DalhousieSpaceSystemsLab/CubeSat-EPS-Hardware/docs/EPS Prototype 1 (cell level protection)/BOM.xlsx

Index | Quantity | Part Number | Manufacturer Part Number | Description | Customer Reference | Available | Backorder | Unit Price | Extended Price CAD
1 | 1 | 63.4KXBK-ND | MFR-25FBF52-63K4 | RES 63.4K OHM 1/4W 1% AXIAL |  | 1 | 0 | 0.14 | 0.14
2 | 2 | 1189-1330-ND | 400LLE2R2MEFC8X9 | CAP ALUM 2.2UF 20% 400V RADIAL |  | 2 | 0 | 0.62 | 1.24
3 | 1 | 513-1673-ND | CTX100-1-52-R | FIXED IND 100UH 2.5A 106 MOHM TH |  | 0 | 1 | 5.14 | 5.14
4 | 1 | 732-7149-ND | 744750230100 | FIXED IND 10UH 4.6A 23 MOHM TH |  | 1 | 0 | 2.54 | 2.54
5 | 1 | CMF1.91MHFCT-ND | CMF551M9100FHEB | RES 1.91M OHM 1/2W 1% AXIAL |  | 1 | 0 | 2.13 | 2.13
6 | 1 | PPC200KW-1CT-ND | PR01000102003JR500 | RES 200K OHM 1W 5% AXIAL |  | 1 | 0 | 0.3 | 0.30
7 | 3 | 399-15738-ND | ESL106M100AE3AA | CAP ALUM 10UF 20% 100V THRU HOLE |  | 3 | 0 | 0.39 | 1.17
8 | 1 | BC4228CT-ND | MRS25000C6193FCT00 | RES 619K OHM 0.6W 1% AXIAL |  | 1 | 0 | 0.35 | 0.35
9 | 3 | P5308-ND | ECA-2AM4R7 | CAP ALUM 4.7UF 20% 100V RADIAL |  | 3 | 0 | 0.33 | 0.99
10 | 2 | P15788CT-ND | EEA-GA1C150B | CAP ALUM 15UF 20% 16V RADIAL |  | 2 | 0 | 0.39 | 0.78
11 | 1 | 490-4927-1-ND | GCM1555C1H221JA16D | CAP CER 220PF 50V C0G/NP0 0402 |  | 1 | 0 | 0.14 | 0.14
12 | 1 | CRM2512-FX-R250ELFCT-ND | CRM2512-FX-R250ELF | RES 0.25 OHM 1% 2W 2512 |  | 1 | 0 | 1.78 | 1.78
13 | 5 | S7000-ND | PPTC021LFBN-RC | CONN HDR 2POS 0.1 TIN PCB |  | 5 | 0 | 0.43 | 2.15
14 | 2 | 641-1303-1-ND | CPDU5V0U-HF | TVS DIODE 5V 12.5V 0603 |  | 2 | 0 | 0.54 | 1.08
15 | 2 | 277-1667-ND | 1935161 | TERM BLK 2POS SIDE ENTRY 5MM PCB |  | 0 | 2 | 0.58 | 1.16
16 | 1 | 1276-1235-1-ND | CL05A105MQ5NNNC | CAP CER 1UF 6.3V X5R 0402 |  | 0 | 1 | 0.14 | 0.14
17 | 10 | 311-1KMCT-ND | RC0201FR-071KL | RES SMD 1K OHM 1% 1/20W 0201 |  | 10 | 0 | 0.058 | 0.58
18 | 1 | UPS115UE3/TR7CT-ND | UPS115UE3/TR7 | DIODE SCHOTTKY 15V 1A POWERMITE |  | 1 | 0 | 1.58 | 1.58
19 | 1 | 513-1548-ND | CTX50-2-52-R | FIXED IND 50UH 4.9A 32.6 MOHM TH |  | 0 | 1 | 7.07 | 7.07
20 | 1 | 478-1129-1-ND | 0402ZD104KAT2A | CAP CER 0.1UF 10V X5R 0402 |  | 1 | 0 | 0.14 | 0.14
21 | 12 | ED11195-ND | 801-47-001-10-001000 | CONN RCPT 1POS GOLD PCB |  | 12 | 0 | 0.552 | 6.62
22 | 2 | RHM330AICT-ND | KTR18EZPF3300 | RES SMD 330 OHM 1% 1/4W 1206 |  | 2 | 0 | 0.29 | 0.58
23 | 2 | 490-13969-1-ND | GRM31CR60J157ME11L | CAP CER 150UF 6.3V X5R 1206 |  | 2 | 0 | 1.55 | 3.10
24 | 3 | SI6423DQ-T1-E3CT-ND | SI6423DQ-T1-E3 | MOSFET P-CH 12V 8.2A 8TSSOP |  | 3 | 0 | 2.51 | 7.53
25 | 1 | 2663S-36-ND | 26633601RP2 | CONN HEADER VERT 36POS 2MM |  | 1 | 0 | 4.48 | 4.48
26 | 2 | WSLC-.06CT-ND | WSL1206R0600FEA | RES 0.06 OHM 1% 1/4W 1206 |  | 2 | 0 | 1.22 | 2.44
27 | 3 | A106650-ND | 215297-3 | CONN RCPT 3POS 0.1 GOLD PCB |  | 3 | 0 | 1.18 | 3.54
28 | 10 | SAM10729-ND | SQT-102-01-F-S | CONN RCPT 2POS 0.079 GOLD PCB |  | 0 | 10 | 0.935 | 9.35
29 | 2 | 1276-1287-1-ND | CL31A226KPHNNNE | CAP CER 22UF 10V X5R 1206 |  | 2 | 0 | 0.54 | 1.08
30 | 2 | 311-7.5KERCT-ND | RC1206JR-077K5L | RES SMD 7.5K OHM 5% 1/4W 1206 |  | 2 | 0 | 0.14 | 0.28
31 | 4 | 563-1976-5-ND | CFS-0102MA | SWITCH DIP SPST 100MA 6V |  | 4 | 0 | 1.67 | 6.68
32 | 2 | LTC6995CS6-1#TRMPBFCT-ND | LTC6995CS6-1#TRMPBF | IC OSC SILICON PROG TSOT23-6 |  | 2 | 0 | 5.41 | 10.82
33 | 2 | 296-37669-1-ND | TPS2557DRBR | IC PWR SWITCH N-CHAN 1:1 8SON |  | 0 | 2 | 2.03 | 4.06
34 | 2 | 408-2038-1-ND | RG3216P-5004-B-T1 | RES 5M OHM 0.1% 1/4W 1206 |  | 2 | 0 | 0.95 | 1.90
35 | 2 | 732-7683-1-ND | 885012208011 | CAP CER 0.47UF 10V X7R 1206 |  | 2 | 0 | 0.26 | 0.52
36 | 2 | LTC4002ES8-4.2#TRPBFCT-ND | LTC4002ES8-4.2#TRPBF | IC BATT CHG LI-ION 1CELL 8SOIC |  | 2 | 0 | 7.19 | 14.38
37 | 2 | A106075CT-ND | CRG1206F2K2 | RES SMD 2.2K OHM 1% 1/4W 1206 |  | 2 | 0 | 0.14 | 0.28
38 | 2 | 296-25857-1-ND | CSD17307Q5A | MOSFET N-CH 30V 14A/73A 8VSON |  | 2 | 0 | 1.11 | 2.22
39 | 3 | 160-1457-1-ND | LTST-C230KRKT | LED RED CLEAR CHIP SMD |  | 3 | 0 | 0.42 | 1.26
40 | 3 | 732-8086-1-ND | 885012208009 | CAP CER 0.1UF 10V X7R 1206 |  | 3 | 0 | 0.15 | 0.45
41 | 2 | TNP2.00KACCT-ND | TNPW12062K00BEEA | RES 2K OHM 0.1% 2/5W 1206 |  | 0 | 2 | 0.91 | 1.82
42 | 2 | B330-FDICT-ND | B330-13-F | DIODE SCHOTTKY 30V 3A SMC |  | 2 | 0 | 0.72 | 1.44
43 | 2 | 36-1042-ND | 1042 | BATTERY HOLDER 18650 SMD TAB |  | 2 | 0 | 5.34 | 10.68
44 | 2 | 1276-1148-1-ND | CL31A106KPHNNNE | CAP CER 10UF 10V X5R 1206 |  | 2 | 0 | 0.3 | 0.60
45 | 2 | IPC0083-ND | IPC0083 | DFN-6 TO DIP-10 SMT ADAPTER |  | 2 | 0 | 6.51 | 13.02
46 | 1 | 495-5572-1-ND | B78108S1682K000 | FIXED IND 6.8UH 670MA 510 MOHM |  | 1 | 0 | 0.52 | 0.52
47 | 1 | HM3316-ND | 1532A | FIXED IND 10UH 1.5A 110 MOHM TH |  | 1 | 0 | 2.83 | 2.83
48 | 1 | 535-13015-ND | AIAP-02-5R6K | FIXED IND 5.6UH 5.6A 24 MOHM TH |  | 1 | 0 | 0.73 | 0.73
