DalhousieSpaceSystemsLab/CubeSat-EPS-Hardware/docs/MPPT Prototype/SPV1040_BOM.xlsx

Index | Quantity | Part Number | Manufacturer Part Number | Description | Customer Reference | Available | Backorder | Unit Price | Extended Price USD
1 | 2 | 497-11417-ND | SPV1040T | IC BATTERY CHARGER SOLAR 8TSSOP |  | 2 | 0 | 3.16 | 6.32
2 | 3 | 490-10525-1-ND | GRM31CD80J107ME39L | CAP CER 100UF 6.3V X6T 1206 |  | 3 | 0 | 0.69 | 2.07
3 | 3 | 399-8131-1-ND | C1206C102J5RACTU | CAP CER 1000PF 50V X7R 1206 |  | 3 | 0 | 0.19 | 0.57
4 | 12 | 2057-SMC-1-01-1-GT-ND | SMC-1-01-1-GT | MACHINE PIN SOCKET 1P 1.00MM PIT |  | 12 | 0 | 0.104 | 1.25
5 | 2 | 311-1.0KERCT-ND | RC1206JR-071KL | RES SMD 1K OHM 5% 1/4W 1206 |  | 2 | 0 | 0.1 | 0.20
6 | 2 | A140693CT-ND | RQ73C2B768KBTD | RES 768 KOHMS 0.1% 0.4W 1206 |  | 2 | 0 | 0.92 | 1.84
7 | 2 | P330KBCCT-ND | ERA-8AEB334V | RES SMD 330K OHM 0.1% 1/4W 1206 |  | 2 | 0 | 0.66 | 1.32
8 | 2 | 495-5656-1-ND | B82442T1103K050 | FIXED IND 10UH 1.42A 132 MOHM |  | 2 | 0 | 1.48 | 2.96
