DalhousieSpaceSystemsLab/CubeSat-EPS-Hardware/docs/POW Subsystem Test Plan.xlsx

 | Power Subsystem Test Plan |  |  |  |  | Document Code: LORIS-POW-TEC-02
Testing Plan:
Requirement | Method of Verification (A, I, D, T) | Facility | Device Used | Description of Test | Success Criteria | Requirement Content For Reference
[SYS-POW-010] |  |  |  |  |  | The spacecraft power generation system shall be made of solar arrays and batteries and shall cope with the power needs of the various spacecraft subsystems as required.
[SYS-POW-020] |  |  |  |  |  | The Power subsystem shall generate, store, manage, and distribute power to support payload and housekeeping operations throughout all mission phases.
[SYS-POW-030] | A, D |  | Multimeter | Battery pack will be monitored with multimeter while providing power to subsystems. | Batteries are demonstrated to store at least 40 Whr | The spacecraft battery shall store a minimum 40 Whr of electrical power to operate the payload and subsystems when solar power is not available.
[SYS-POW-031] | A, T |  | MATLAB | Simulations are run to determine state of worst case eclipse. Batteries are tested to this limit. | Batteries are shown to sustain enough power to survive worst case eclipse scenarios | The spacecraft battery shall be sized for worst case eclipses.
[SYS-POW-032] | A, D |  | Multimeter | Batteries will be charged until overcharge circuitry prevents charging. | Overcharge circuitry demonstrates that the energy stored shall not exceed 80Whr | Total chemical energy stored shall not exceed 80 Whr as specified by Nanoracks in [AD4].
[SYS-POW-040] | A,T |  | Multimeter, External Power supply | Protection circuitry will be tested by forcing the battery pack into over charge/discharge conditions. | Protection circuitrysucesfully protects battery back against over-charge, over-discharge, short-circuit, charge over-current, and discharge over-current events. | The battery pack must contain integrated protection against over-charge, over-discharge, short-circuit, charge over-current, and discharge over-current events.
[SYS-POW-050] | I, T |  | Multimeter | A external charging port will be designed then integrated with the battery pack then tested using a multimeter | Batteries scuesfully gain charge via external charging port
[SYS-POW-051] | A, D |  | Multimeter | All subsystems are disconnected from ground when external charging port is in use | External charging port only provides power to battery pack | The external charging port must not provide power to any of the loads.
[SYS-POW-060] | D |  | N/A | The spacecraft development will use test batteries |  | Test batteries shall be used during ground test activities.
[SYS-POW-061] | D |  | N/A | Flight cells will be used to power final stages of spacecraft leveling testing | Flight batteries sucesfully supply power in final spacecraft level testing. | Flight batteries shall be included in final spacecraft level testing.
[SYS-POW-080] | A |  | MATLAB | Simulations are run to determine depth of discharge over 9 months. | Depth of discharge over 9 months is less than 50% | While in a cold launch configuration, the batteries shall be capable of holding a charge for 9 months with a resulting DoD of no more than 50%.
[SYS-POW-090] | A |  | CAD Software, Visual inspection | Confirmed by reviewing circuit design and board design that regulators are placed for centralized distributions | Regulators are centralized to minimize path of power | The PDU shall have centralized power distribution.
[SYS-POW-100] | D |  | Master/Slave connection | PDU will turn active loads on and off. PDU will monitor andgenerate reports of voltage and current consumptions. | PDU monitors and controls power distribution and sucesfully generates reports upon request. | The PDU shall perform power conditioning, switching, internal monitoring and reporting of voltage and current.
[SYS-POW-110] | A, D |  | Multimeter, External Power supply | Load switches will be stressed test with over voltage, over current and under voltage scenarios | PDU is sucesfully protects itself and subsystems from over voltage/current and under voltage protection | The PDU shall include necessary over voltage, over current, and under voltage protection.
[SYS-POW-120] | D |  | Multimeter | PDU board voltage lines will be measured while providing to load(s) | 3.3±0.2V and 5±0.2V measurements are taken | The PDU shall provide regulated 3.3±0.2V and 5±0.2V supply.
[SYS-POW-130] | D |  | Master/Slave connection | OBC request telemetry from PDU | OBC sucesfully receives data request from PDU | The PDU shall provide all necessary telemetry data to the OBC.
[SYS-POW-140] | D |  | Multimeter | Multimeter will be used to measure power supplied to during a power intensive operations. | Power observed is 10 W or greater | The PDU shall supply at least 10 W during transient power-intensive operations such as during downlink.
[SYS-POW-150] | D |  | Multimeter | Multimeter will be used to measure power supplied to during a nominal operation | Power observed is 4 W or greater | The PDU shall supply at least 4 W during nominal operations.
[SYS-POW-160] | D |  | Multimeter | Multimeter will be used to measure instantaneous current of a load that draws more then 150% of its max expected load current | Load switches sucesfully latch at 150% of each loads expected max current. Load switches sucesfully reset the power. | Each power line shall provide an appropriately sized resettable latching current limit equal to 150% of max expected load for each circuit.
[SYS-POW-170] | D |  | Multimeter | Load switches will be toggled on and off | Load switches sucesfully turn a load on/off | Each power channel shall be capable of being turned on and off in response to commands from the OBC.
[SYS-POW-180] | I |  | Multimeter | Multimeter will be used to check for path to ground. | Every point on spacecraft is an open circuit to ground. | The power subsystem shall include a minimum of three inhibit switches that keep the satellite in a powered-down state.
[SYS-POW-181] | D |  | Multimeter | Run a demonstration of the timer circuitry | Power system is activated only after 30 minute timer | The PDU shall provide power to the loads at least 30 minutes after all three inhibit switches are closed.
[SYS-POW-182] | D |  | Multimeter | Run a demonstration of the timer circuitry, toggling an inhibit switch to test the timer reset | Timer is reset after the toggle is switched | If any of the three inhibit switches are toggled during the 30-minute period, the timer must reset.
[SYS-POW-190] | I, D | NR Int. Facility |  |  |  | The power subsystem shall be in a power off state while integrated in the CubeSat deployer from the time of delivery to the Launch Vehicle (LV) through on-orbit deployment.
[SYS-POW-200] | I, D |  | Multimeter | Multimeter will be used to check for path to ground. | RBF pin sucessfuly removes path to ground. | LORIS shall have a remove before flight (RBF) feature or an apply before flight (ABF) feature that keeps the satellite in an unpowered state throughout the ground handling and integration process into the deployer.
[SYS-POW-201] | I, D | NR Int. Facility |  |  |  | The RBF pin shall cut all power to the satellite once it is inserted into the CubeSat Deployer.
[SYS-POW-202] | D | NR Int. Facility |  |  |  | The RBF pin shall be removed after integration into the CubeSat Deployer.
[SYS-POW-220] | A,D, T |  | Multimeter, Oscilloscope | Osciloscope will be used to measure the SNR at various points of the spacecraft to ground. | Electrical noise from ground do not cause systems to behave undefined. | The power subsystem shall be designed to be free of any grounding issues that affect the performance of the components.
[SYS-POW-230] | A, T |  | N/A | Lifetime of solar cells must be greater then 1.5 years | Solar cells chosen must have lifetime of 1.5 years | The solar panels shall have an operational lifetime of at least 1.5 years
[SYS-POW-231] | A, T |  | MATLAB | MATLAB simulations will be used to perfom accelerated fatigue test. | Simulations result in EOL better than 25% effeciency | The solar panels shall be at least 25% efficient at end of life.
[SYS-POW-240] | D |  | Multimeter | Over current protection will be monitored for over current scenarios. | Power distribution to each subsystem does not cause shorts. | The power subsystem shall provide the grounding and bonding interface between connected systems with no shorts between ground lines and power supply lines.
[SYS-POW-250] | A, D |  | Scale | A scale is used to measure the mass of the power subsystem | The mass is less than 500 g | The power subsystem shall have a mass that does not exceed 500 g.
[SYS-POW-260] | D | NR Int. Facility
