DalhousieSpaceSystemsLab/CubeSat-EPS-Hardware/docs/Solar Wall Prototype/Wall Dimensions.PDF

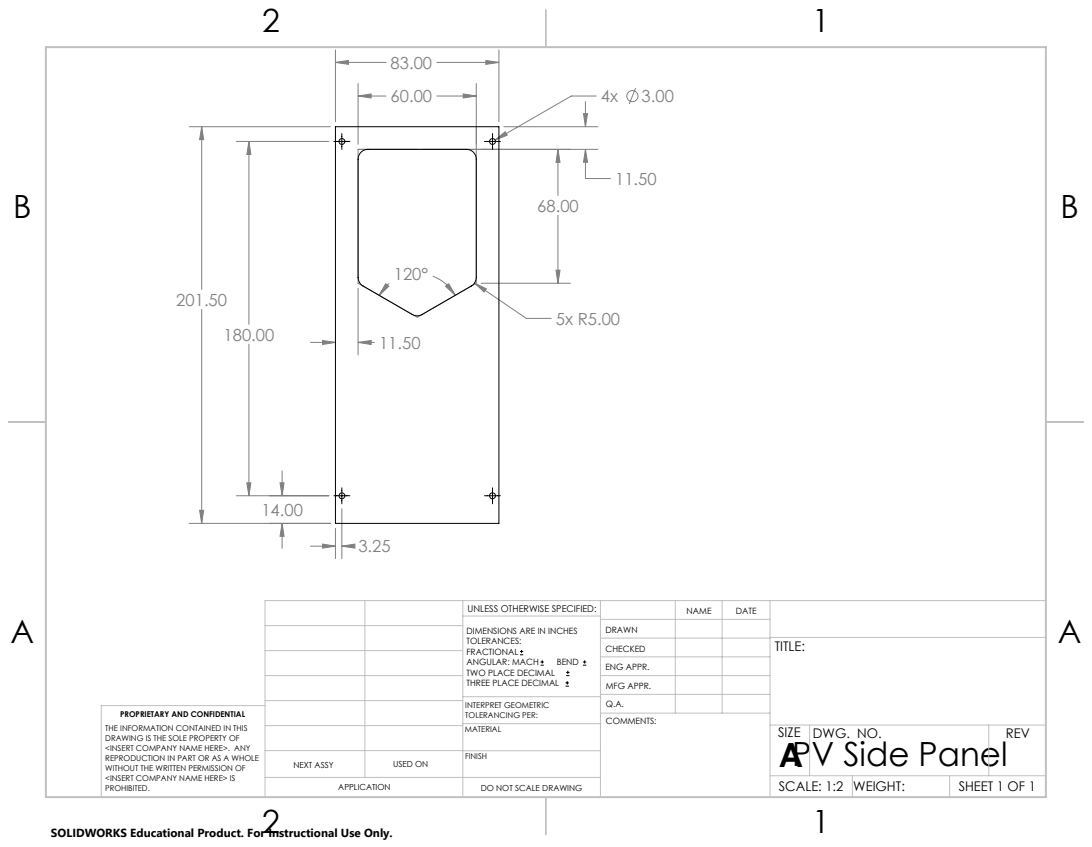
[picture p38: page 1]

UNLESS OTHERWISE SPECIFIED: | | NAME | DATE
DIMENSIONS ARE IN INCHES TOLERANCES: FRACTIONAL ANGULAR: MACH BEND TWO PLACE DECIMAL THREE PLACE DECIMAL | DRAWN

CHECKED | | | TITLE:

ENG APPR.
MFG APPR.

INTERPRET GEOMETRIC TOLERANCING PER: | Q.A.
MATERIAL | | SIZE A PV Side Panel | DWG. NO. | REV

PROPRIETARY AND CONFIDENTIAL
THE INFORMATION CONTAINED IN THIS
DRAWING IS THE SOLE PROPERTY OF
<INSERT COMPANY NAME HERE>. ANY
REPRODUCTION IN PART OR AS A WHOLE
WITHOUT THE WRITTEN PERMISSION OF
<INSERT COMPANY NAME HERE> IS
PROHIBITED.

NEXT ASSY | USED ON | FINISH

APPLICATION | DO NOT SCALE DRAWING | | SCALE: 1:2 | WEIGHT: | SHEET 1 OF 1

SOLIDWORKS Educational Product. For Instructional Use Only.
