DalhousieSpaceSystemsLab/CubeSat-EPS-Hardware/eagle project/PDUv1/PDUv1.pdf

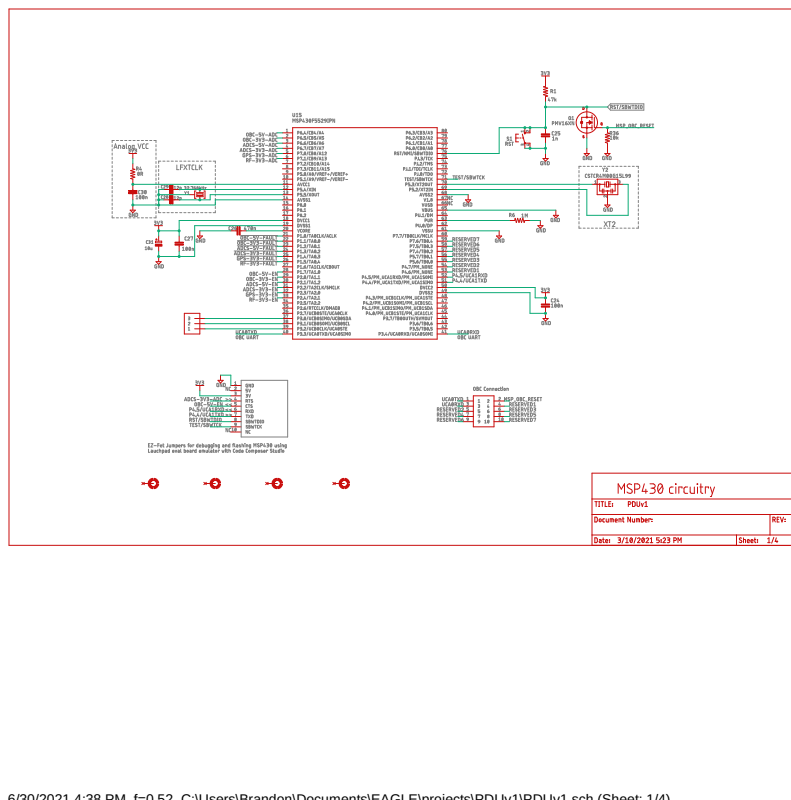
[picture p40: page 1]

6/30/2021 4:38 PM f=0.52 C:\Users\Brandon\Documents\EAGLE\projects\PDUv1\PDUv1.sch (Sheet: 1/4)

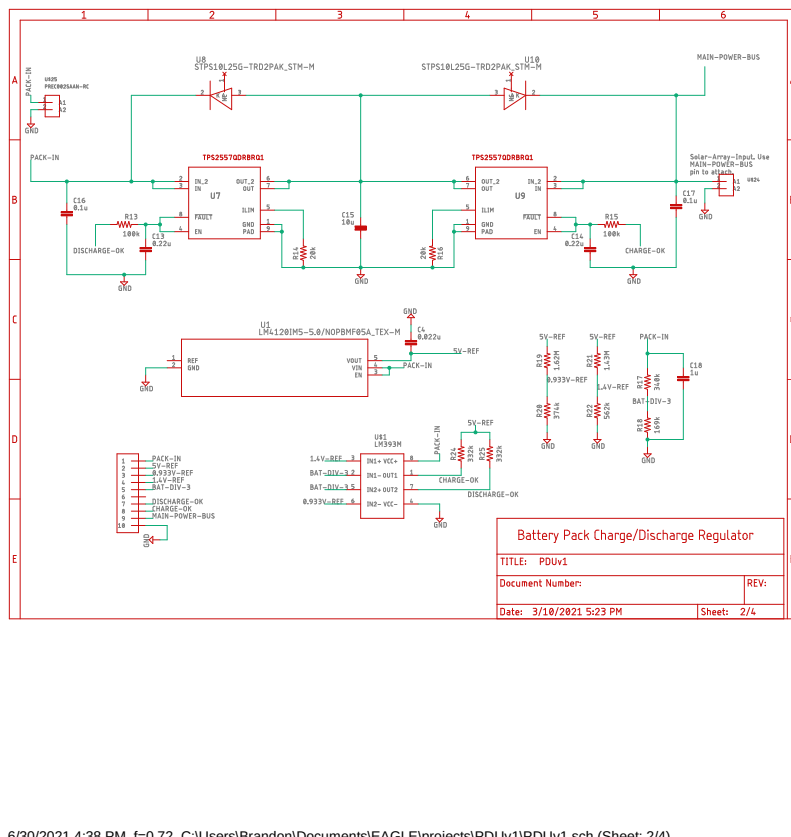
[picture p41: page 2]

6/30/2021 4:38 PM f=0.72 C:\Users\Brandon\Documents\EAGLE\projects\PDUv1\PDUv1.sch (Sheet: 2/4)

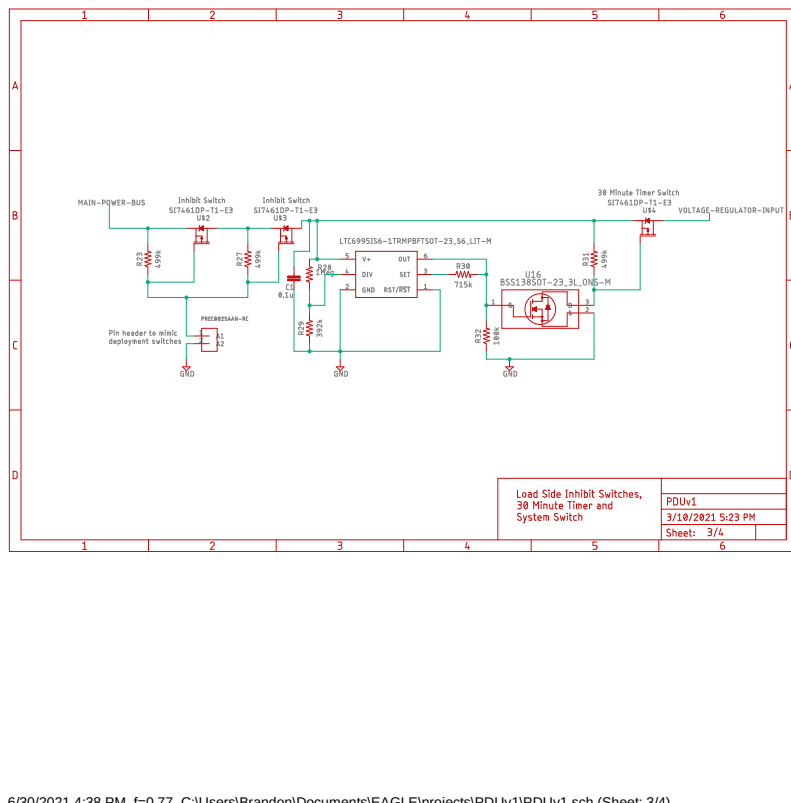
[picture p42: page 3]

6/30/2021 4:38 PM f=0.77 C:\Users\Brandon\Documents\EAGLE\projects\PDUv1\PDUv1.sch (Sheet: 3/4)

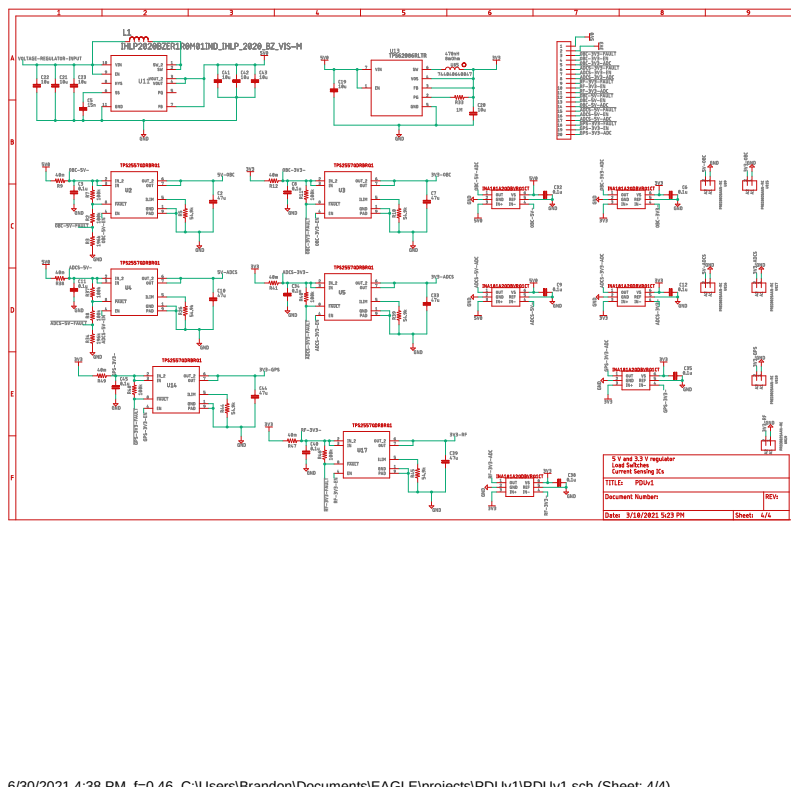
[picture p43: page 4]

6/30/2021 4:38 PM f=0.46 C:\Users\Brandon\Documents\EAGLE\projects\PDUv1\PDUv1.sch (Sheet: 4/4)
