DalhousieSpaceSystemsLab/CubeSat-EPS-Hardware/eagle project/PDUv2/PDUv2.brd

## EAGLE design eagle project/PDUv2/PDUv2.brd (2021-08-02)

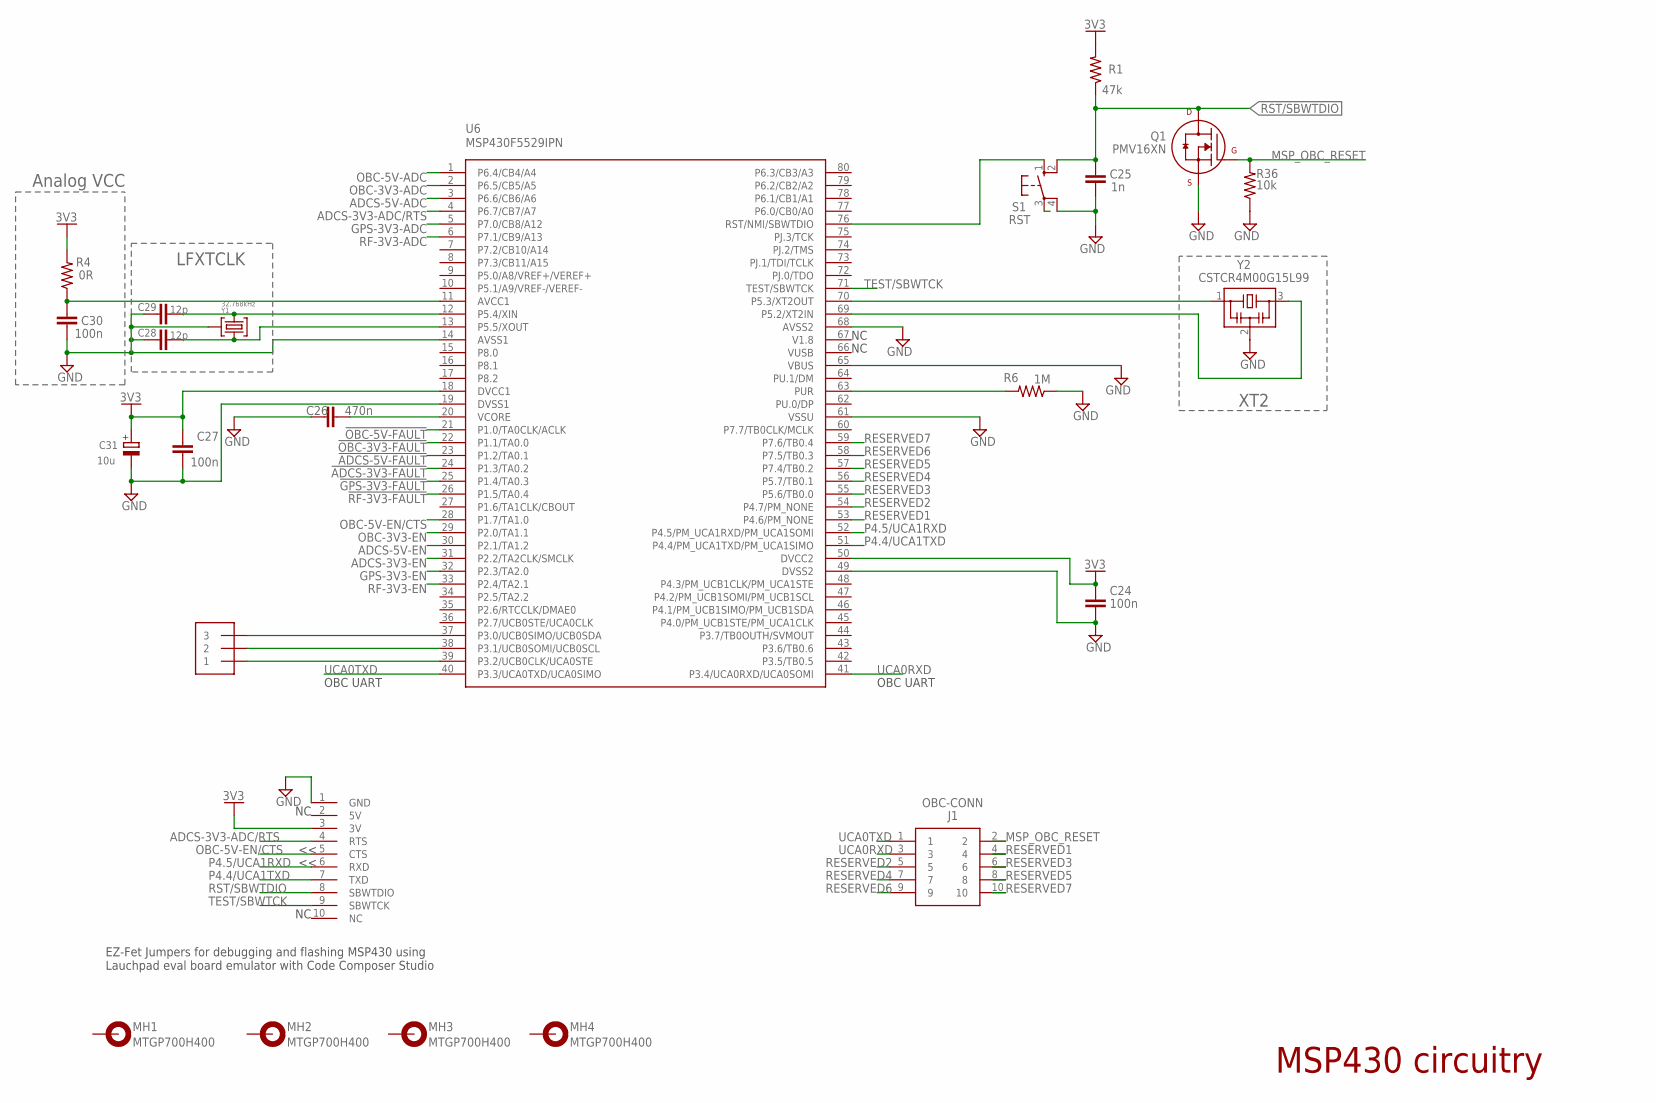
[picture p44: schematic PDUv2.sch, sheet 1]

Parts:
C24, C27, C30: 100n; C0402
C25: 1n; C0402
C26: 470n; C0402
C28, C29: 12p; C0402
C31: 10u; A/3216-18R
J1: OBC-CONN
J5: HDR_10_EZFET_DEBUGGER; HDRV10W66P254_10X1_2540X254H858
MH1, MH2, MH3, MH4: MTGP700H400
Q1: PMV16XN; SOT23-3P95_230X110L20X43N_PMV16XN
R1: 47k; R0402
R4: 0R; R0402
R6: 1M; R0603
R36: 10k; R0603
S1: RST; B3F-10XX
U6: MSP430F5529IPN; QFP80P50_1400X1400X160L60X22N
U$23: GRPB031VWTC-RC
Y1: 32.768kHz; MS3V-T1R
Y2: CSTCR4M00G15L99; MURATA-FILTER_CSTCR

Connections:
3V3: C27.2, C31.+, J5.3 (3V), R1.2, R4.2, U6.18 (DVCC1); also elsewhere on the board
!ADCS-3V3-FAULT: U6.24 (P1.3/TA0.2); also elsewhere on the board
!ADCS-5V-FAULT: U6.23 (P1.2/TA0.1); also elsewhere on the board
!GPS-3V3-FAULT: U6.25 (P1.4/TA0.3); also elsewhere on the board
!OBC-3V3-FAULT: U6.22 (P1.1/TA0.0); also elsewhere on the board
!OBC-5V-FAULT: U6.21 (P1.0/TA0CLK/ACLK); also elsewhere on the board
!RF-3V3-FAULT: U6.26 (P1.5/TA0.4); also elsewhere on the board
ADCS-3V3-ADC/RTS: J5.4 (RTS), U6.4 (P6.7/CB7/A7); also elsewhere on the board
ADCS-3V3-EN: U6.31 (P2.2/TA2CLK/SMCLK); also elsewhere on the board
ADCS-5V-ADC: U6.3 (P6.6/CB6/A6); also elsewhere on the board
ADCS-5V-EN: U6.30 (P2.1/TA1.2); also elsewhere on the board
AVCC1: C30.1, R4.1, U6.11 (AVCC1)
GND: C24.2, C25.2, C26.1, C27.1, C28.1, C29.1, C30.2, C31.-, J5.1 (GND), Q1.2 (S), R6.1, R36.1, S1.4 (P1), U6.14 (AVSS1), U6.19 (DVSS1), U6.49 (DVSS2), U6.61 (VSSU), U6.65 (VBUS), U6.68 (AVSS2), Y1.P3 (GND), Y2.2; also elsewhere on the board
GPS-3V3-ADC: U6.5 (P7.0/CB8/A12); also elsewhere on the board
GPS-3V3-EN: U6.32 (P2.3/TA2.0); also elsewhere on the board
MSP_OBC_RESET: J1.2, Q1.1 (G), R36.2
unnamed: C24.1, U6.50 (DVCC2)
unnamed: S1.1 (S), U6.76 (RST/NMI/SBWTDIO)
OBC-3V3-ADC: U6.2 (P6.5/CB5/A5); also elsewhere on the board
OBC-3V3-EN: U6.29 (P2.0/TA1.1); also elsewhere on the board
OBC-5V-ADC: U6.1 (P6.4/CB4/A4); also elsewhere on the board
OBC-5V-EN/CTS: J5.5 (CTS), U6.28 (P1.7/TA1.0); also elsewhere on the board
P4.4/UCA1TXD: J5.7 (TXD), U6.51 (P4.4/PM_UCA1TXD/PM_UCA1SIMO)
P4.5/UCA1RXD: J5.6 (RXD), U6.52 (P4.5/PM_UCA1RXD/PM_UCA1SOMI)
P5.2/XT2IN1: U6.69 (P5.2/XT2IN), Y2.3
P5.3/XT2OUT1: U6.70 (P5.3/XT2OUT), Y2.1
P5.4/XIN1: C29.2, U6.12 (P5.4/XIN), Y1.P1 (1)
P5.5/XOUT1: C28.2, U6.13 (P5.5/XOUT), Y1.P2 (2)
RESERVED1: J1.4, U6.53 (P4.6/PM_NONE)
RESERVED2: J1.5, U6.54 (P4.7/PM_NONE)
RESERVED3: J1.6, U6.55 (P5.6/TB0.0)
RESERVED4: J1.7, U6.56 (P5.7/TB0.1)
RESERVED5: J1.8, U6.57 (P7.4/TB0.2)
RESERVED6: J1.9, U6.58 (P7.5/TB0.3)
RESERVED7: J1.10, U6.59 (P7.6/TB0.4)
RF-3V3-ADC: U6.6 (P7.1/CB9/A13); also elsewhere on the board
RF-3V3-EN: U6.33 (P2.4/TA2.1); also elsewhere on the board
RST/SBWTDIO: C25.1, J5.8 (SBWTDIO), Q1.3 (D), R1.1, S1.2 (S1)
TARGET_PUR: R6.2, U6.63 (PUR)
TEST/SBWTCK: J5.9 (SBWTCK), U6.71 (TEST/SBWTCK)
UCA0RXD: J1.3, U6.41 (P3.4/UCA0RXD/UCA0SOMI)
UCA0TXD: J1.1, U6.40 (P3.3/UCA0TXD/UCA0SIMO)
UCB0CLK: U6.39 (P3.2/UCB0CLK/UCA0STE), U$23.1
UCB0SCL: U6.38 (P3.1/UCB0SOMI/UCB0SCL), U$23.2
UCB0SDA: U6.37 (P3.0/UCB0SIMO/UCB0SDA), U$23.3
VCORE1: C26.2, U6.20 (VCORE)

Notes on the sheet:
LFXTCLK
XT2
Analog VCC
OBC UART
EZ-Fet Jumpers for debugging and flashing MSP430 using Lauchpad eval board emulator with Code Composer Studio
MSP430 circuitry

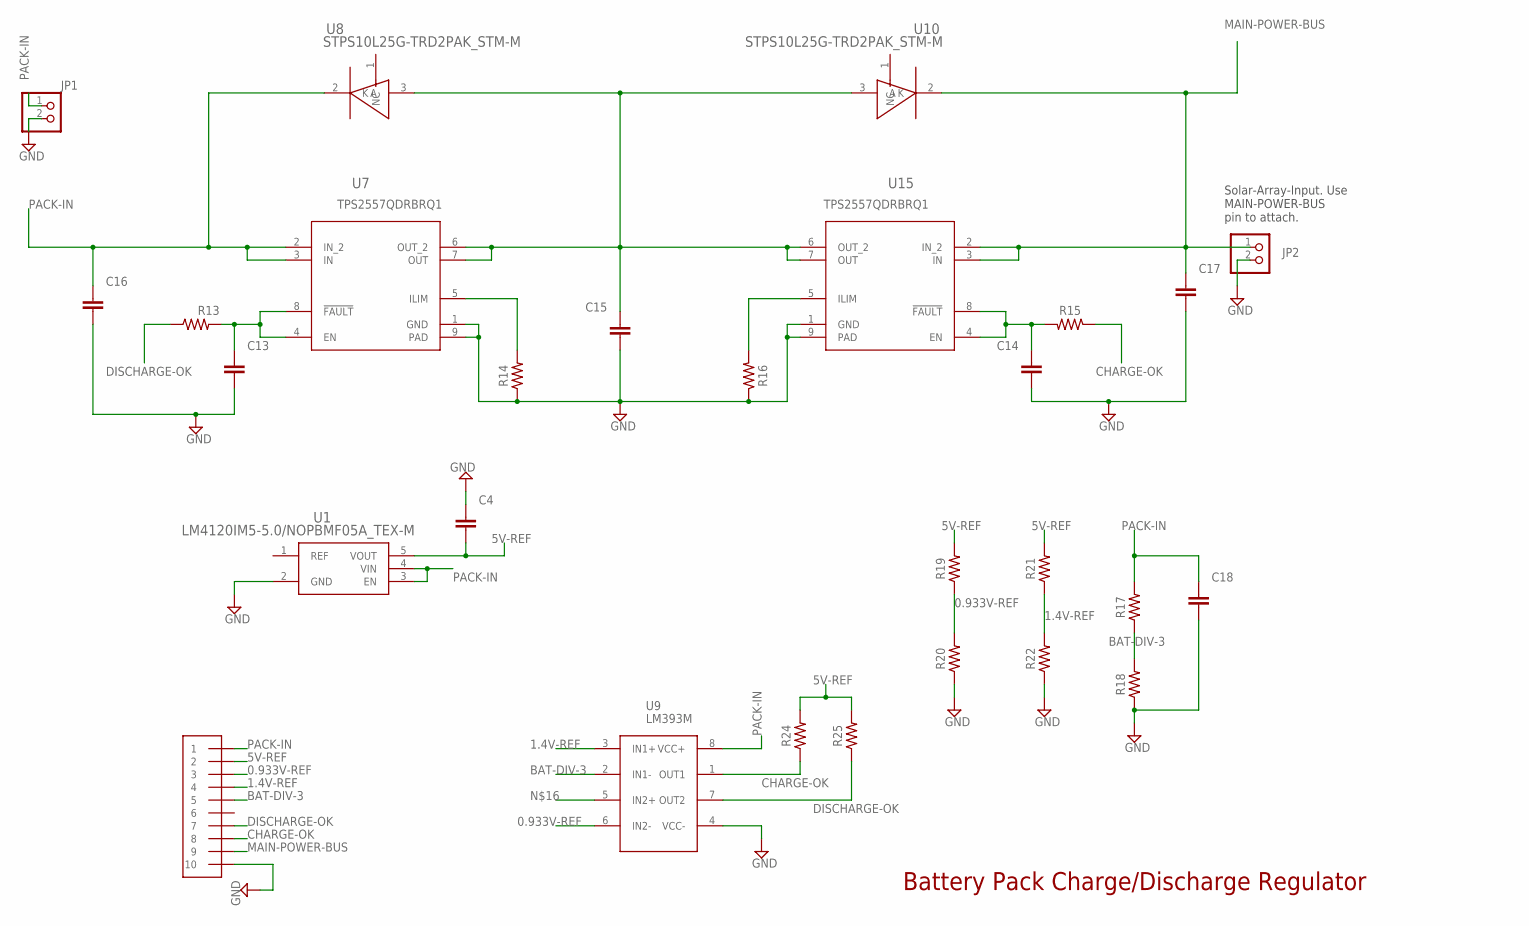
[picture p45: schematic PDUv2.sch, sheet 2]

Parts:
C4: 0.022u; CAPC1608X85
C13, C14: 0.22u; CAPC1608X85
C15: 10u; CAPC1608X85
C16, C17: 0.1u; CAPC1608X85
C18: 1u; CAPC1608X85
JP1, JP2: PINHD-1X2; 1X02
R13, R15: 100k; RESC1608X60
R14, R16: 20k; RESC1608X60
R17: 340k; RESC1608X60
R18: 169k; RESC1608X60
R19: 1.62M; RESC1608X60
R20: 374k; RESC1608X60
R21: 1.43M; RESC1608X60
R22: 562k; RESC1608X60
R24, R25: 332k; RESC1608X60
U1: LM4120IM5-5.0/NOPBMF05A_TEX-M; MF05A_TEX-M
U7, U15: Value; DRB0008B
U8, U10: STPS10L25G-TRD2PAK_STM-M; D2PAK_STM-M
U9: LM393M; M08A-M
U$20: GRPB052VWQS-RC

Connections:
0.933V-REF: R19.1, R20.2, U9.6 (IN2-), U$20.3
1.4V-REF: R21.1, R22.2, U9.3 (IN1+), U$20.4
5V-REF: C4.2, R19.2, R21.2, R24.2, R25.2, U1.5 (VOUT), U$20.2
BAT-DIV-3: R17.1, R18.2, U9.2 (IN1-), U$20.5
CHARGE-OK: R15.1, R24.1, U9.1 (OUT1), U$20.8
DISCHARGE-OK: R13.1, R25.1, U9.7 (OUT2), U$20.7
GND: C4.1, C13.2, C14.2, C15.2, C16.2, C17.2, C18.2, JP1.2, JP2.2, R14.1, R16.1, R18.1, R20.1, R22.1, U1.2 (GND), U7.1 (GND), U7.9 (PAD), U9.4 (VCC-), U15.1 (GND), U15.9 (PAD), U$20.10; also elsewhere on the board
MAIN-POWER-BUS: C17.1, JP2.1, U10.2 (K), U15.2 (IN_2), U15.3 (IN), U$20.9; also elsewhere on the board
unnamed: C15.1, U7.6 (OUT_2), U7.7 (OUT), U8.3 (A), U10.3 (A), U15.6 (OUT_2), U15.7 (OUT)
unnamed: C13.1, R13.2, U7.4 (EN), U7.8 (!FAULT)
unnamed: R14.2, U7.5 (ILIM)
unnamed: C14.1, R15.2, U15.4 (EN), U15.8 (!FAULT)
unnamed: R16.2, U15.5 (ILIM)
PACK-IN: C16.1, C18.1, JP1.1, R17.2, U1.3 (EN), U1.4 (VIN), U7.2 (IN_2), U7.3 (IN), U8.2 (K), U9.8 (VCC+), U$20.1

Notes on the sheet:
Solar-Array-Input. Use MAIN-POWER-BUS pin to attach.
Battery Pack Charge/Discharge Regulator

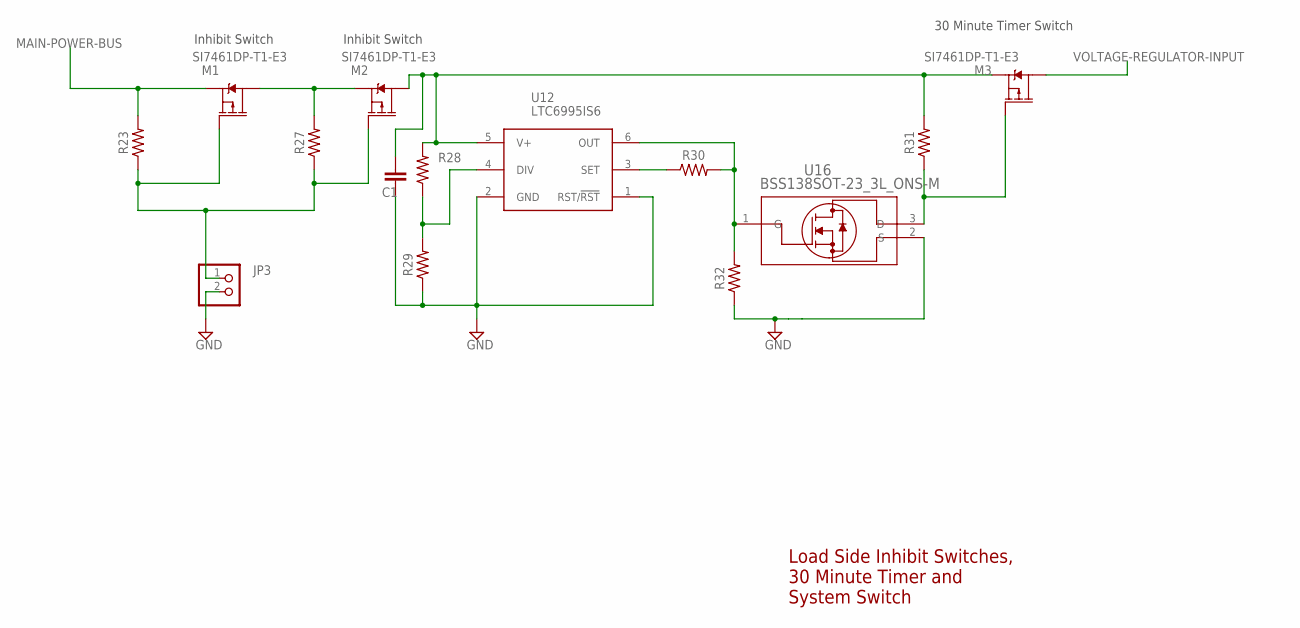
[picture p46: schematic PDUv2.sch, sheet 3]

Parts:
C1: 0.1u; CAPC1608X85
JP3: PINHD-1X2; 1X02
M1, M2, M3: SI7461DP-T1-E3; MOSFET_65DP-T1-E3_VIS
R23, R27, R31: 499k; RESC1608X60
R28: 1Meg; RESC1608X60
R29: 392k; RESC1608X60
R30: 715k; RESC1608X60
R32: 100k; RESC1608X60
U12: LTC6995IS6; TSOT-23_S6_LIT
U16: BSS138SOT-23_3L_ONS-M; SOT-23_3L_ONS-M

Connections:
GND: C1.2, JP3.2, R29.1, R32.1, U12.1 (RST/!RST), U12.2 (GND), U16.2 (S); also elsewhere on the board
MAIN-POWER-BUS: M1.1 (S), M1.2 (S), M1.3 (S), R23.2; also elsewhere on the board
unnamed: M3.4 (G), R31.1, U16.3 (D)
unnamed: JP3.1, M1.4 (G), M2.4 (G), R23.1, R27.1
unnamed: C1.1, M2.5 (D), M2.6 (D), M2.7 (D), M2.8 (D), M3.1 (S), M3.2 (S), M3.3 (S), R28.2, R31.2, U12.5 (V+)
unnamed: M1.5 (D), M1.6 (D), M1.7 (D), M1.8 (D), M2.1 (S), M2.2 (S), M2.3 (S), R27.2
unnamed: R28.1, R29.2, U12.4 (DIV)
unnamed: R30.1, U12.3 (SET)
unnamed: R30.2, R32.2, U12.6 (OUT), U16.1 (G)
VOLTAGE-REGULATOR-INPUT: M3.5 (D), M3.6 (D), M3.7 (D), M3.8 (D); also elsewhere on the board

Notes on the sheet:
Inhibit Switch
30 Minute Timer Switch
Load Side Inhibit Switches, 30 Minute Timer and System Switch

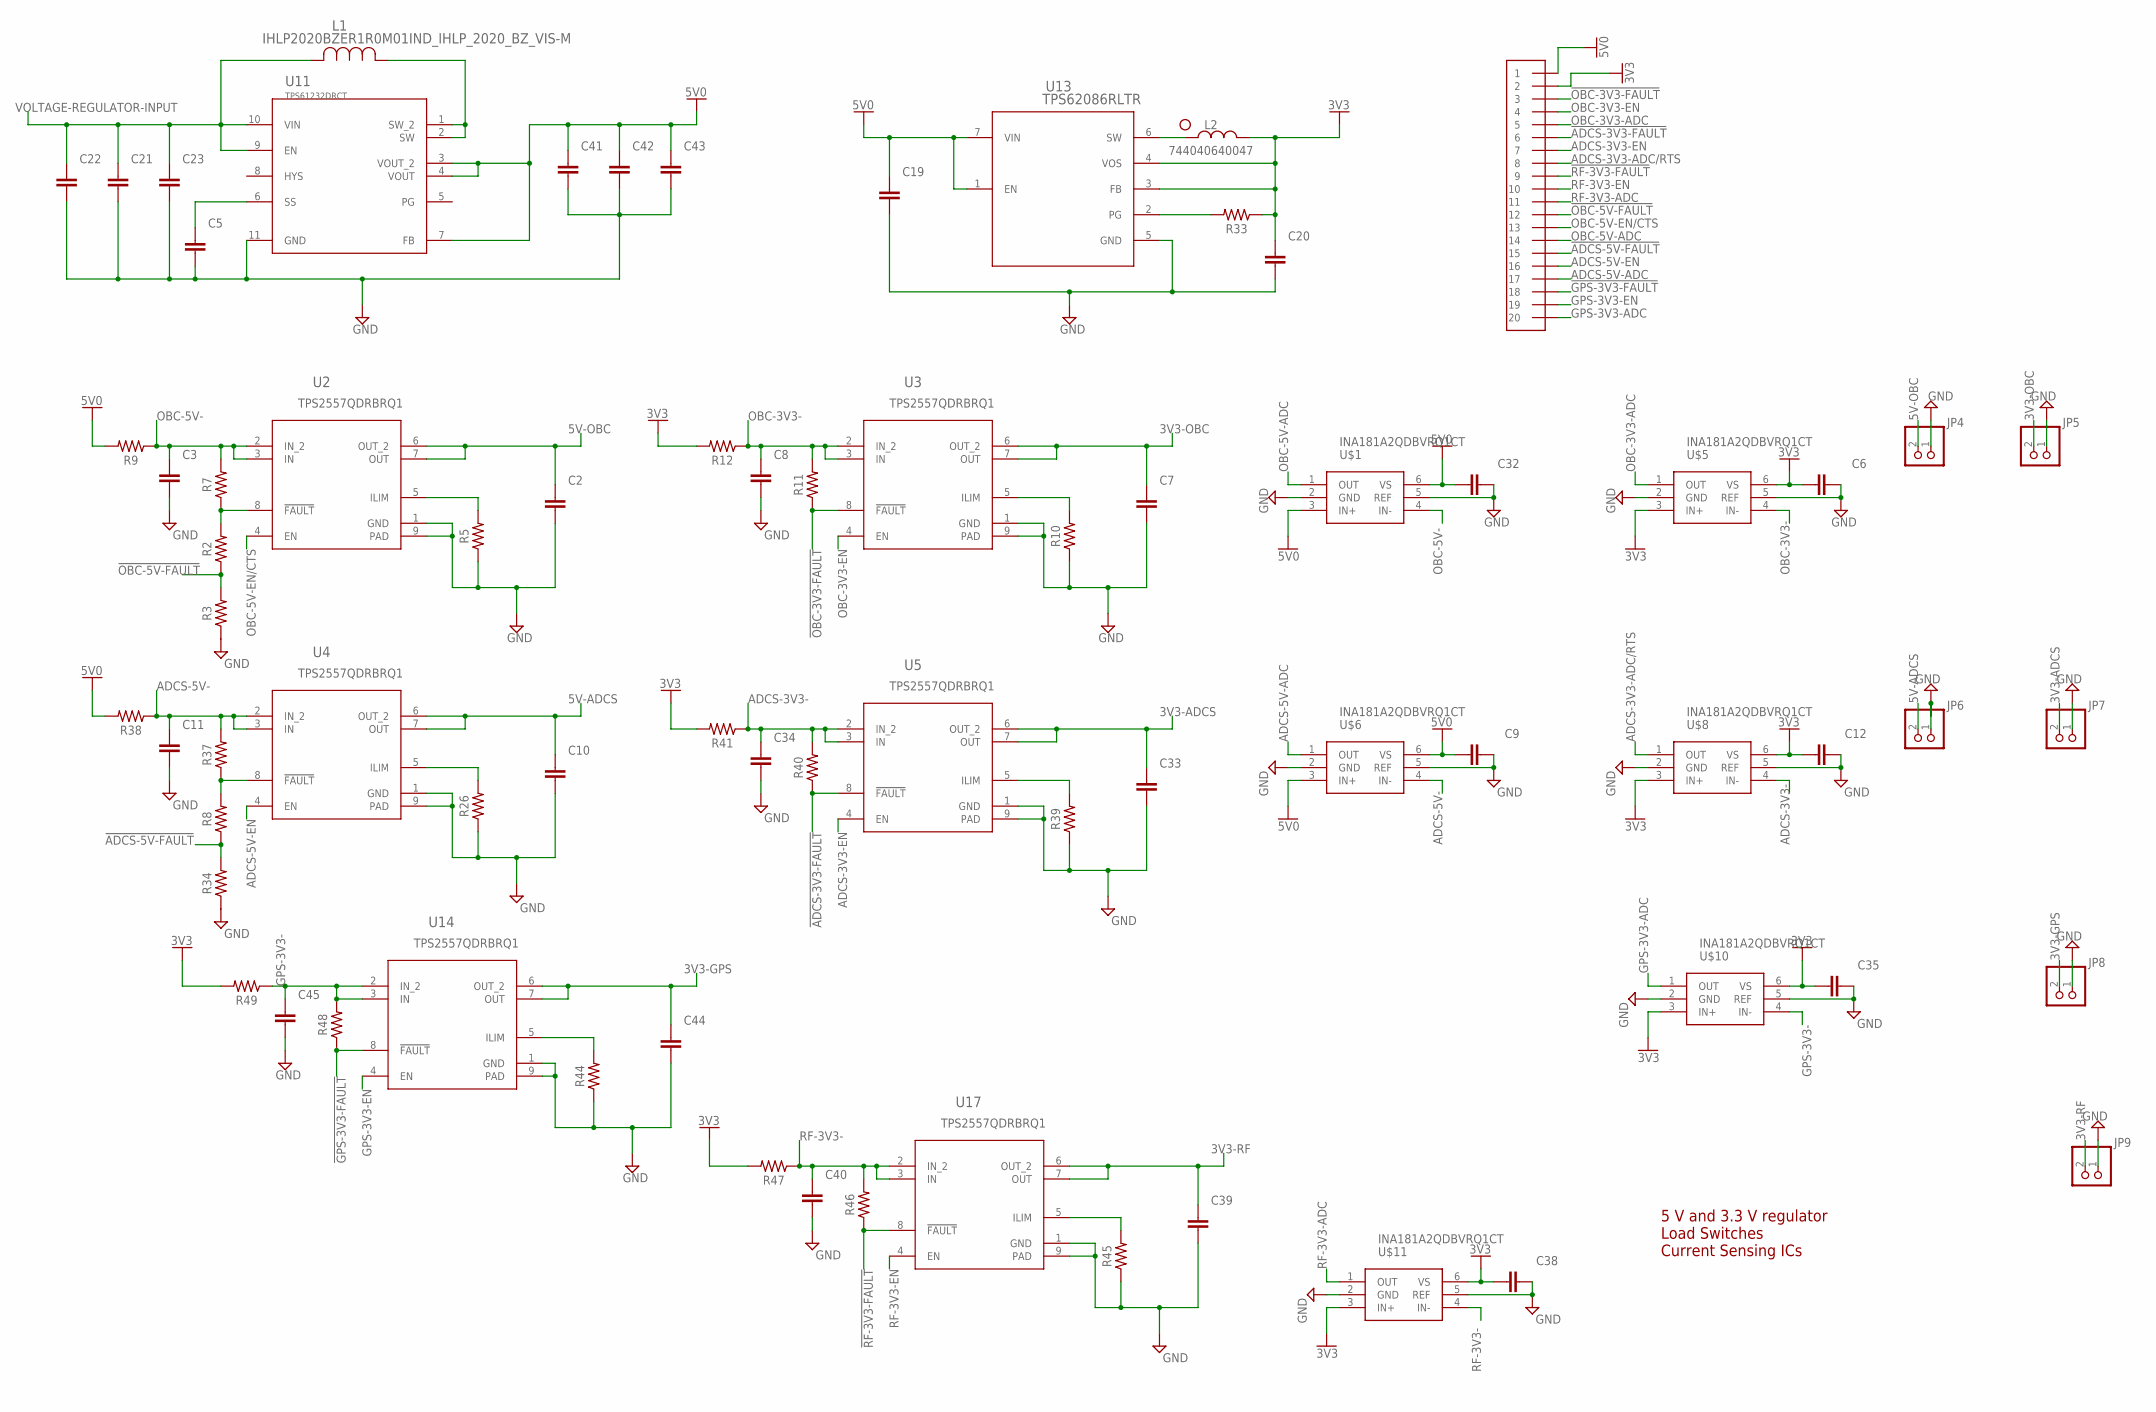
[picture p47: schematic PDUv2.sch, sheet 4]

Parts:
C2, C7, C10, C33, C39, C44: 47u; CAPC1608X85
C3, C6, C8, C9, C11, C12, C32, C34, C35, C38, C40, C45: 0.1u; CAPC1608X85
C5: 15n; CAPC1608X85
C19, C20, C21, C22, C23, C41, C42, C43: 10u; CAPC1608X85
JP4, JP5, JP6, JP7, JP8, JP9: PINHD-1X2; 1X02
L1: IHLP2020BZER1R0M01IND_IHLP_2020_BZ_VIS-M; IND_IHLP_2020_BZ_VIS-M
L2: 744040640047
R2, R7, R8, R11, R37, R40, R46, R48: 100k; RESC1608X60
R3, R34: 196k; RESC1608X60
R5, R10, R26, R39, R44, R45: 54.9k; RESC1608X60
R9, R12, R38, R41, R47, R49: 40m; RESC1608X60
R33: 1M; RESC1608X60
U2, U3, U4, U5, U14, U17: Value; DRB0008B
U11: TPS61232DRCT; DRC0010G
U13: TPS62086RLTR; RLT0007A
U$1, U$5, U$6, U$8, U$10, U$11: INA181A2QDBVRQ1CT; TSOT-23_S6_LIT-M
U$21: GRPB102VWQS-RC

Connections:
3V3: C6.1, C12.1, C20.1, C35.1, C38.1, L2.2, R12.2, R33.1, R41.2, R47.2, R49.2, U13.3 (FB), U13.4 (VOS), U$5.6 (VS), U$8.6 (VS), U$10.6 (VS), U$11.6 (VS), U$21.2; also elsewhere on the board
3V3-ADCS: C33.1, JP7.2, U5.6 (OUT_2), U5.7 (OUT)
3V3-GPS: C44.1, JP8.2, U14.6 (OUT_2), U14.7 (OUT)
3V3-OBC: C7.1, JP5.2, U3.6 (OUT_2), U3.7 (OUT)
3V3-RF: C39.1, JP9.2, U17.6 (OUT_2), U17.7 (OUT)
5V0: C19.1, C41.1, C42.1, C43.1, R9.2, R38.2, U11.3 (VOUT_2), U11.4 (VOUT), U11.7 (FB), U13.1 (EN), U13.7 (VIN), U$1.3 (IN+), U$6.3 (IN+), U$21.1
5V-ADCS: C10.1, JP6.2, U4.6 (OUT_2), U4.7 (OUT)
5V-OBC: C2.1, JP4.2, U2.6 (OUT_2), U2.7 (OUT)
!ADCS-3V3-FAULT: R40.1, U5.8 (!FAULT), U$21.6; also elsewhere on the board
!ADCS-5V-FAULT: R8.1, R34.2, U$21.15; also elsewhere on the board
!GPS-3V3-FAULT: R48.1, U14.8 (!FAULT), U$21.18; also elsewhere on the board
!OBC-3V3-FAULT: R11.1, U3.8 (!FAULT), U$21.3; also elsewhere on the board
!OBC-5V-FAULT: R2.1, R3.2, U$21.12; also elsewhere on the board
!RF-3V3-FAULT: R46.1, U17.8 (!FAULT), U$21.9; also elsewhere on the board
ADCS-3V3-: C34.1, R40.2, R41.1, U5.2 (IN_2), U5.3 (IN), U$8.4 (IN-)
ADCS-3V3-ADC/RTS: U$8.1 (OUT), U$21.8; also elsewhere on the board
ADCS-3V3-EN: U5.4 (EN), U$21.7; also elsewhere on the board
ADCS-5V-: C11.1, R37.2, R38.1, U4.2 (IN_2), U4.3 (IN), U$6.4 (IN-)
ADCS-5V-ADC: U$6.1 (OUT), U$21.17; also elsewhere on the board
ADCS-5V-EN: U4.4 (EN), U$21.16; also elsewhere on the board
GND: C2.2, C3.2, C5.2, C6.2, C7.2, C8.2, C9.2, C10.2, C11.2, C12.2, C19.2, C20.2, C21.2, C22.2, C23.2, C32.2, C33.2, C34.2, C35.2, C38.2, C39.2, C40.2, C41.2, C42.2, C43.2, C44.2, C45.2, JP4.1, JP5.1, JP6.1, JP7.1, JP8.1, JP9.1, R3.1, R5.1, R10.1, R26.1, R34.1, R39.1, R44.1, R45.1, U2.1 (GND), U2.9 (PAD), U3.1 (GND), U3.9 (PAD), U4.1 (GND), U4.9 (PAD), U5.1 (GND), U5.9 (PAD), U11.11 (GND), U13.5 (GND), U14.1 (GND), U14.9 (PAD), U17.1 (GND), U17.9 (PAD), U$1.5 (REF), U$5.5 (REF), U$6.5 (REF), U$8.5 (REF), U$10.5 (REF), U$11.5 (REF); also elsewhere on the board
GPS-3V3-: C45.1, R48.2, R49.1, U14.2 (IN_2), U14.3 (IN), U$10.4 (IN-)
GPS-3V3-ADC: U$10.1 (OUT), U$21.20; also elsewhere on the board
GPS-3V3-EN: U14.4 (EN), U$21.19; also elsewhere on the board
unnamed: R5.2, U2.5 (ILIM)
unnamed: R10.2, U3.5 (ILIM)
unnamed: R26.2, U4.5 (ILIM)
unnamed: R39.2, U5.5 (ILIM)
unnamed: R45.2, U17.5 (ILIM)
unnamed: R2.2, R7.1, U2.8 (!FAULT)
unnamed: R8.2, R37.1, U4.8 (!FAULT)
unnamed: L1.1, U11.1 (SW_2), U11.2 (SW)
unnamed: C5.1, U11.6 (SS)
unnamed: R44.2, U14.5 (ILIM)
unnamed: C32.1, U$1.6 (VS)
unnamed: L2.1 (DOT), U13.6 (SW)
unnamed: R33.2, U13.2 (PG)
unnamed: C9.1, U$6.6 (VS)
OBC-3V3-: C8.1, R11.2, R12.1, U3.2 (IN_2), U3.3 (IN), U$5.4 (IN-)
OBC-3V3-ADC: U$5.1 (OUT), U$21.5; also elsewhere on the board
OBC-3V3-EN: U3.4 (EN), U$21.4; also elsewhere on the board
OBC-5V-: C3.1, R7.2, R9.1, U2.2 (IN_2), U2.3 (IN), U$1.4 (IN-)
OBC-5V-ADC: U$1.1 (OUT), U$21.14; also elsewhere on the board
OBC-5V-EN/CTS: U2.4 (EN), U$21.13; also elsewhere on the board
RF-3V3-: C40.1, R46.2, R47.1, U17.2 (IN_2), U17.3 (IN), U$11.4 (IN-)
RF-3V3-ADC: U$11.1 (OUT), U$21.11; also elsewhere on the board
RF-3V3-EN: U17.4 (EN), U$21.10; also elsewhere on the board
VOLTAGE-REGULATOR-INPUT: C21.1, C22.1, C23.1, L1.2, U11.9 (EN), U11.10 (VIN); also elsewhere on the board

Notes on the sheet:
5 V and 3.3 V regulator Load Switches Current Sensing ICs

Board: 2 copper layers, 139 parts (0 on the bottom side), 94 nets, no tracks yet.
