DalhousieSpaceSystemsLab/CubeSat-EPS-Hardware/eagle project/Solar Panel Wing/SolarWing.brd

## EAGLE design eagle project/Solar Panel Wing/SolarWing.brd (2021-07-28)

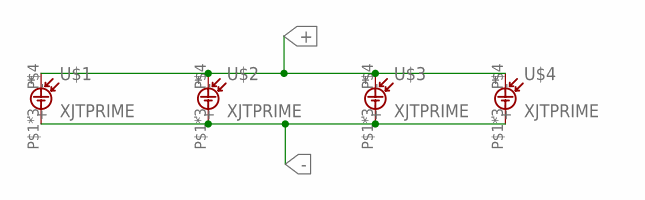
[picture p48: schematic SolarWing.sch]

Parts:
U$1, U$2, U$3, U$4: XJTPRIME

Connections:
+: U$1.P$4 (+), U$2.P$4 (+), U$3.P$4 (+), U$4.P$4 (+)
-: U$1.P$1 (-), U$1.P$2 (-), U$1.P$3 (-), U$2.P$1 (-), U$2.P$2 (-), U$2.P$3 (-), U$3.P$1 (-), U$3.P$2 (-), U$3.P$3 (-), U$4.P$1 (-), U$4.P$2 (-), U$4.P$3 (-)

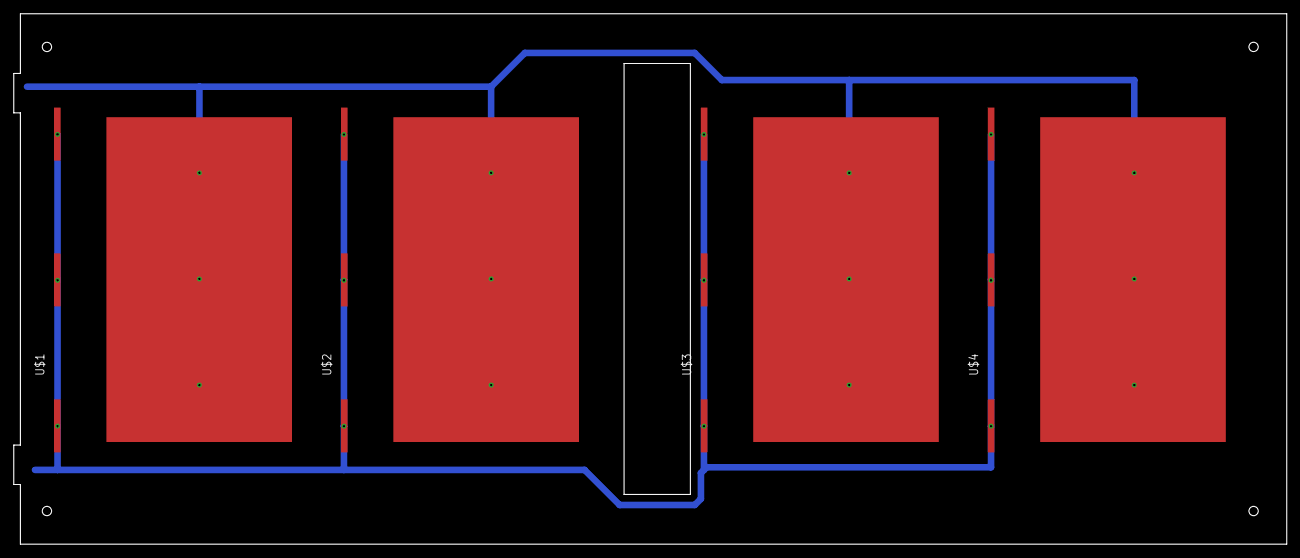
[picture p49: board SolarWing.brd from above]

Board: 2 copper layers, 192.0 x 80.0 mm, 4 parts (0 on the bottom side), 2 nets.
