DalhousieSpaceSystemsLab/CubeSat-EPS-Hardware/(commit log)

2021-07-01 moved over to organization loris organization
    [BOM.xlsx, PDUv1-BOM.csv, PDUv1.brd, PDUv1.sch, POW Subsystem Test Plan.xlsx, SPV1040_BOM.xlsx, master_power_budget.xlsx]
2021-07-28 added wall
    [SolarWing.brd, SolarWing.sch]
2021-08-02 added 2nd prog
    [PDUv2.brd, PDUv2.sch]
