DalhousieSpaceSystemsLab/CubeSat-EPS-Hardware/(notices)

Notices in the files:
parts and their libraries:
PDUv1: COPYRIGHT: Copyright (C) 2018 Accelerated Designs. All rights reserved
